noriakinakagawa/JetsonXaiverNX-UPS/README.md

# JetsonXaiverNX-UPS
Jetson Xaiver NXのための、市販のRC用Li-Poバッテリを電源とするUPS装置。
