noriakinakagawa/JetsonXaiverNX-UPS/3Dmodel/CP_Elec_10x10.step

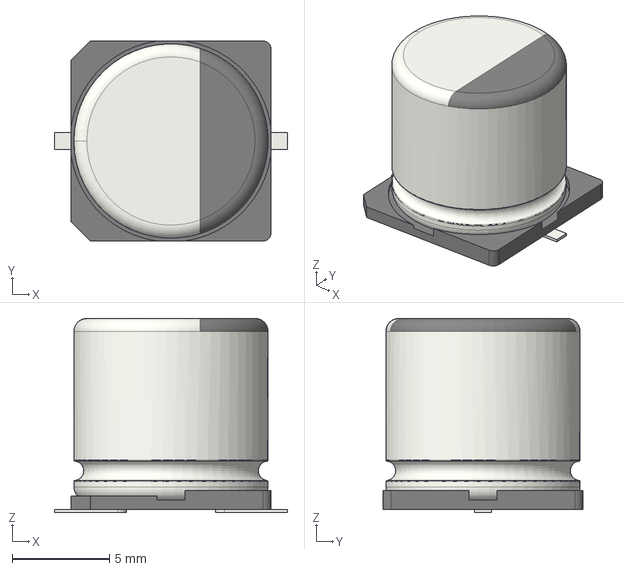
[picture p1: CAD file, 2021-01-03]
3Dmodel/CP_Elec_10x10.step
12.0 x 10.3 x 10.0 mm
