noriakinakagawa/JetsonXaiverNX-UPS/PJ-002B/PJ-002B.step

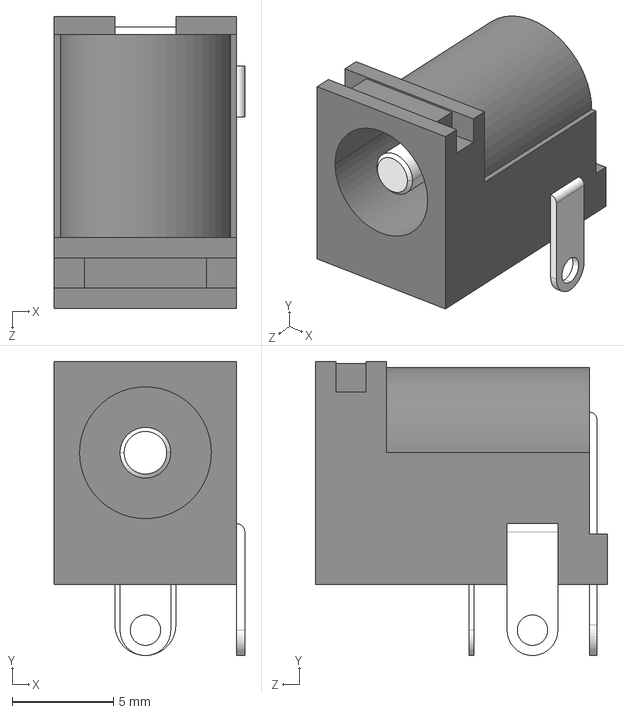
[picture p2: CAD file, 2021-01-03]
PJ-002B/PJ-002B.step
9.40 x 14.5 x 14.4 mm
