noriakinakagawa/JetsonXaiverNX-UPS/3Dmodel/JST_XH_B2B-XH-A_1x02_P2.50mm_Vertical.step

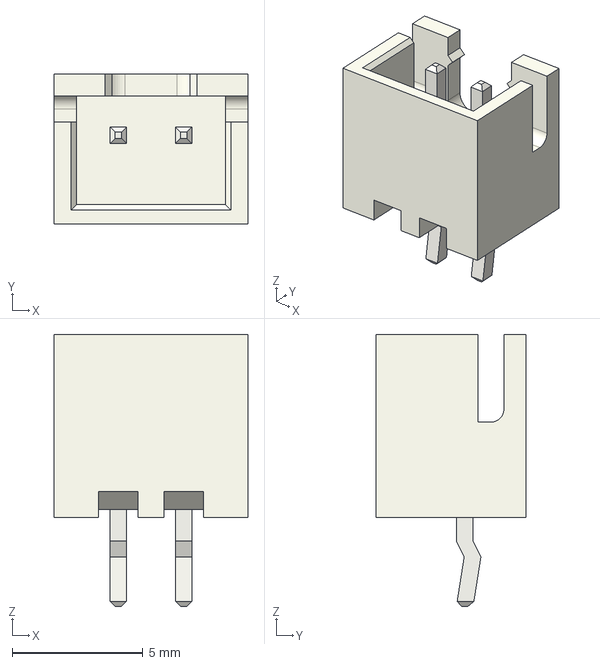
[picture p3: CAD file, 2021-01-03]
3Dmodel/JST_XH_B2B-XH-A_1x02_P2.50mm_Vertical.step
7.40 x 5.75 x 10.4 mm
