noriakinakagawa/JetsonXaiverNX-UPS/3Dmodel/JST_PH_B6B-PH-K_1x06_P2.00mm_Vertical.step

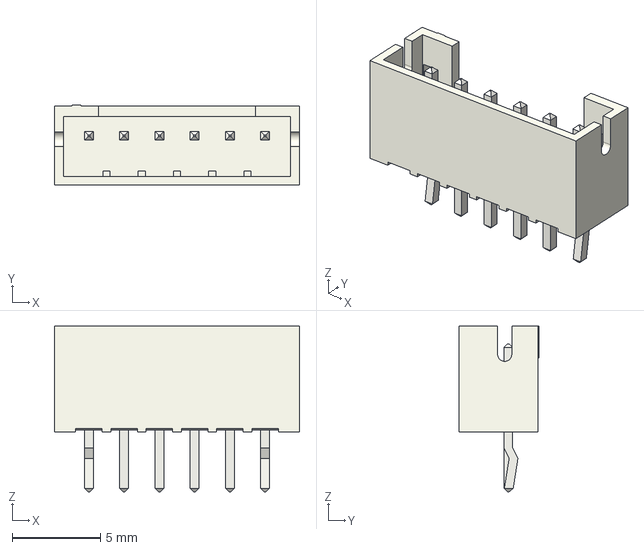
[picture p4: CAD file, 2021-01-03]
3Dmodel/JST_PH_B6B-PH-K_1x06_P2.00mm_Vertical.step
13.9 x 4.55 x 9.40 mm
