noriakinakagawa/JetsonXaiverNX-UPS/3Dmodel/LiPo3S1000mAh_Turnigy.stp

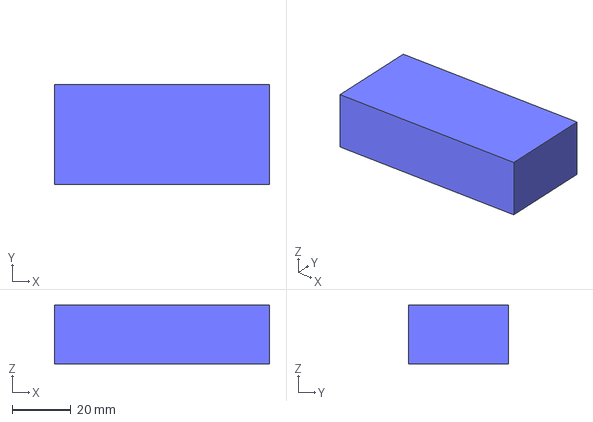
[picture p5: CAD file, 2021-01-03]
3Dmodel/LiPo3S1000mAh_Turnigy.stp
73.0 x 34.0 x 20.0 mm
