noriakinakagawa/JetsonXaiverNX-UPS/3Dmodel/LiPoCharger3S.step

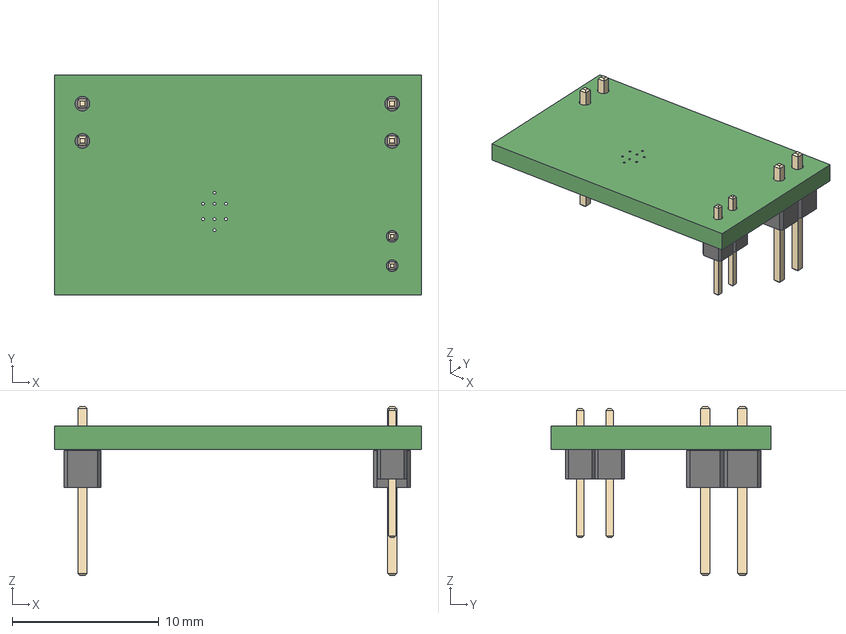
[picture p6: CAD file, 2021-01-03]
3Dmodel/LiPoCharger3S.step
25.0 x 15.0 x 11.5 mm
