noriakinakagawa/JetsonXaiverNX-UPS/3Dmodel/CP_Elec_6.3x5.9.step

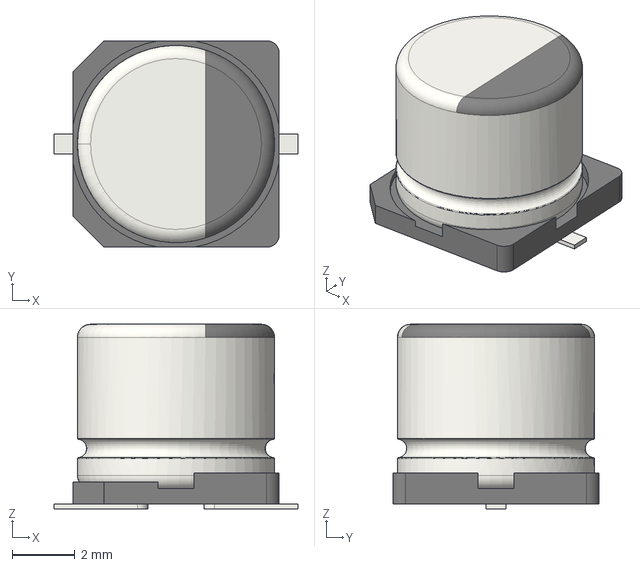
[picture p7: CAD file, 2021-01-03]
3Dmodel/CP_Elec_6.3x5.9.step
7.80 x 6.60 x 5.90 mm
