noriakinakagawa/JetsonXaiverNX-UPS/3Dmodel/JST_XH_B4B-XH-A_1x04_P2.50mm_Vertical.step

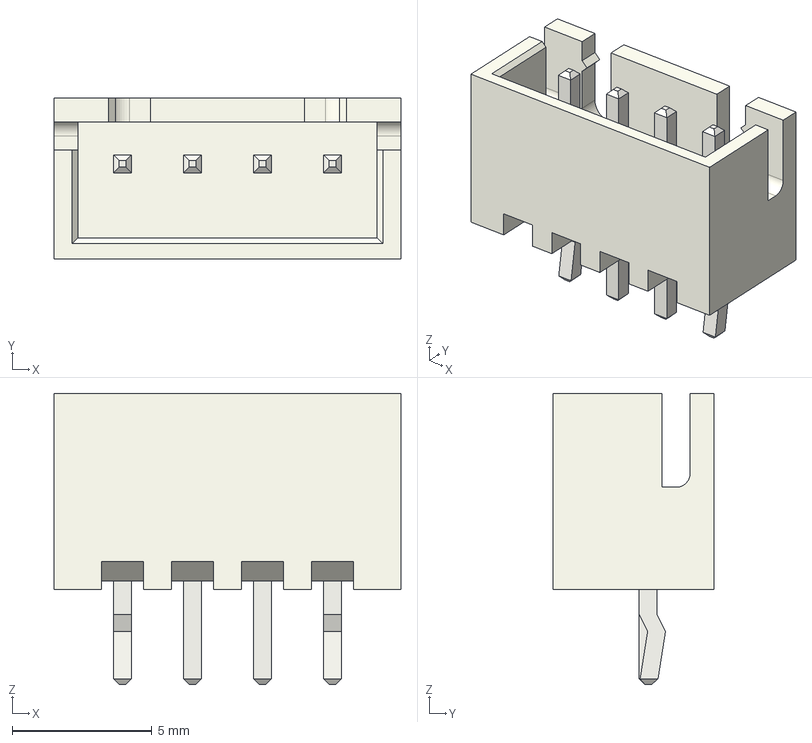
[picture p8: CAD file, 2021-01-03]
3Dmodel/JST_XH_B4B-XH-A_1x04_P2.50mm_Vertical.step
12.4 x 5.75 x 10.4 mm
