noriakinakagawa/JetsonXaiverNX-UPS/3Dmodel/MGFS80.stp

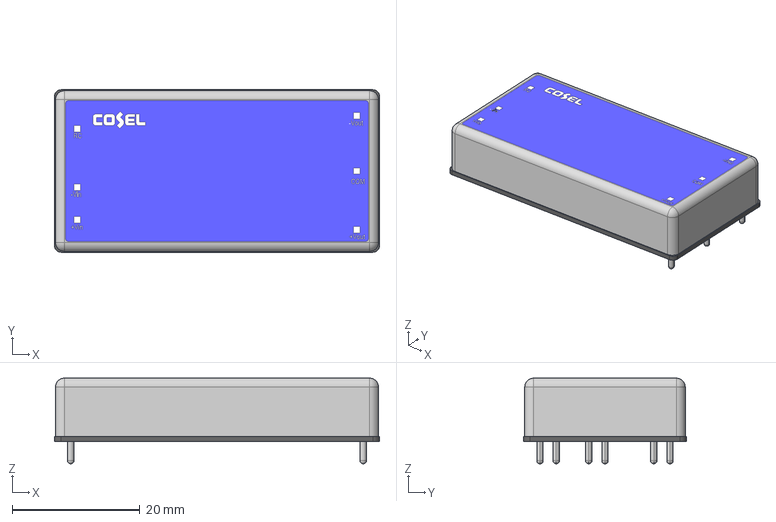
[picture p9: CAD file, 2021-01-03]
3Dmodel/MGFS80.stp
50.8 x 25.4 x 13.4 mm
