noriakinakagawa/JetsonXaiverNX-UPS/3Dmodel/JST_PH_B4B-PH-K_1x04_P2.00mm_Vertical.step

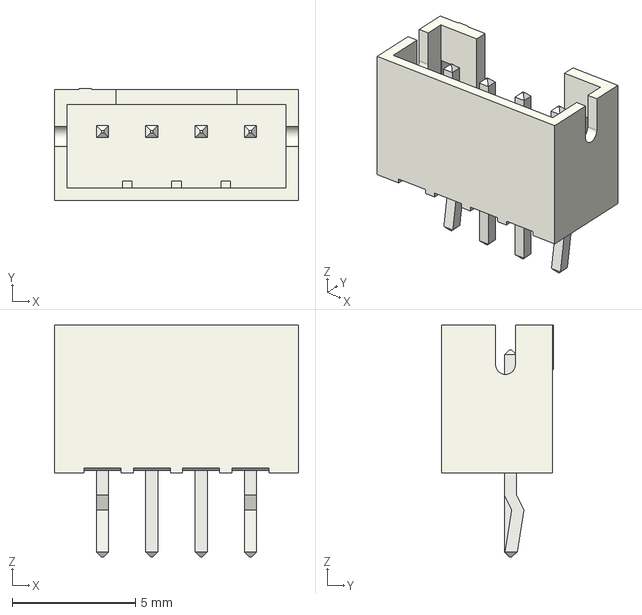
[picture p10: CAD file, 2021-01-03]
3Dmodel/JST_PH_B4B-PH-K_1x04_P2.00mm_Vertical.step
9.90 x 4.55 x 9.40 mm
