noriakinakagawa/JetsonXaiverNX-UPS/JetsonXavierNX_UPS.pdf

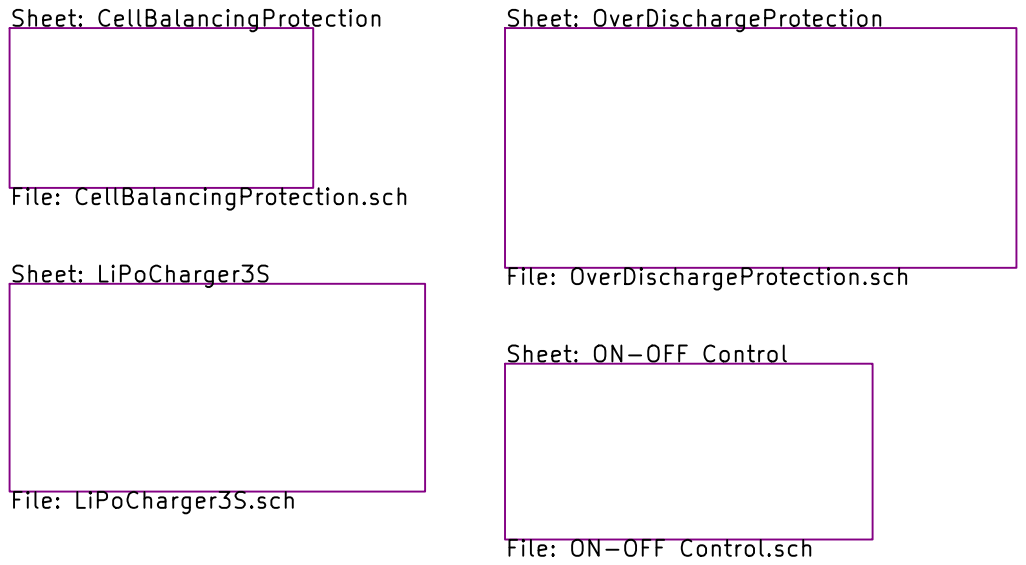
[picture p11: page 1]

File: JetsonXavierNX_UPS.sch Sheet: / Noriaki Nakagawa

Id: 1/5 Title: Jetson Xavier NX UPS

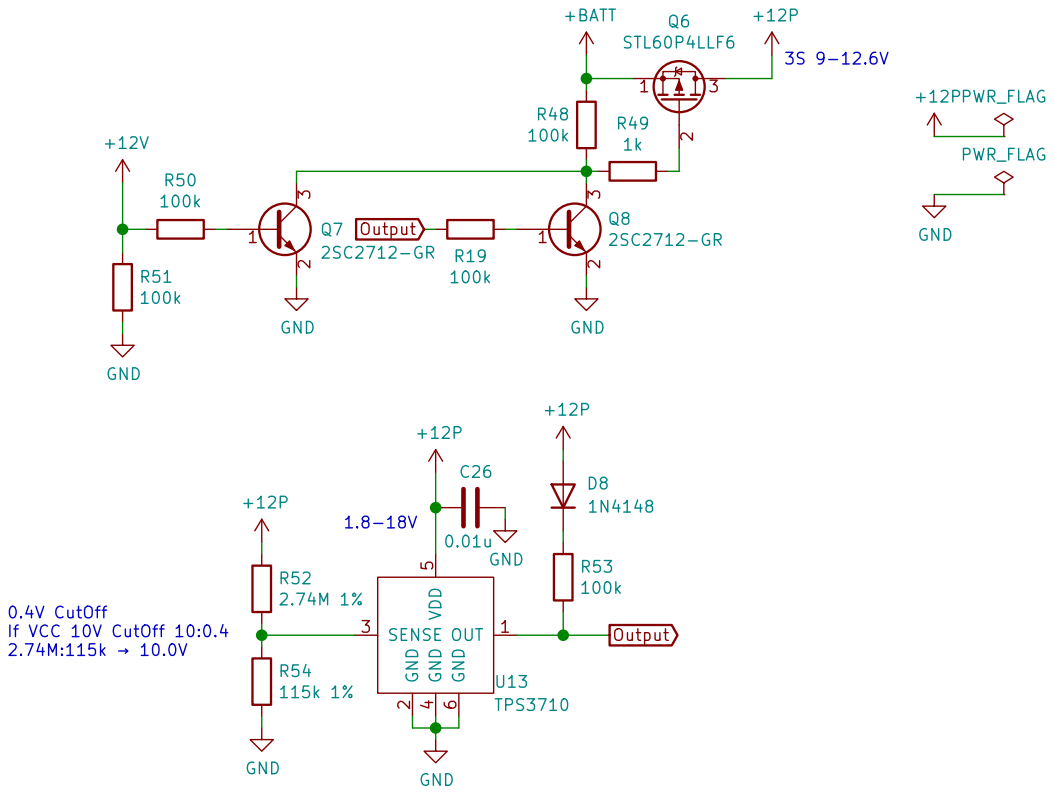
[picture p12: page 2]

Sheet: /OverDischargeProtection/
File: OverDischargeProtection.sch
Id: 2/5 Title: Over Discharge Protection

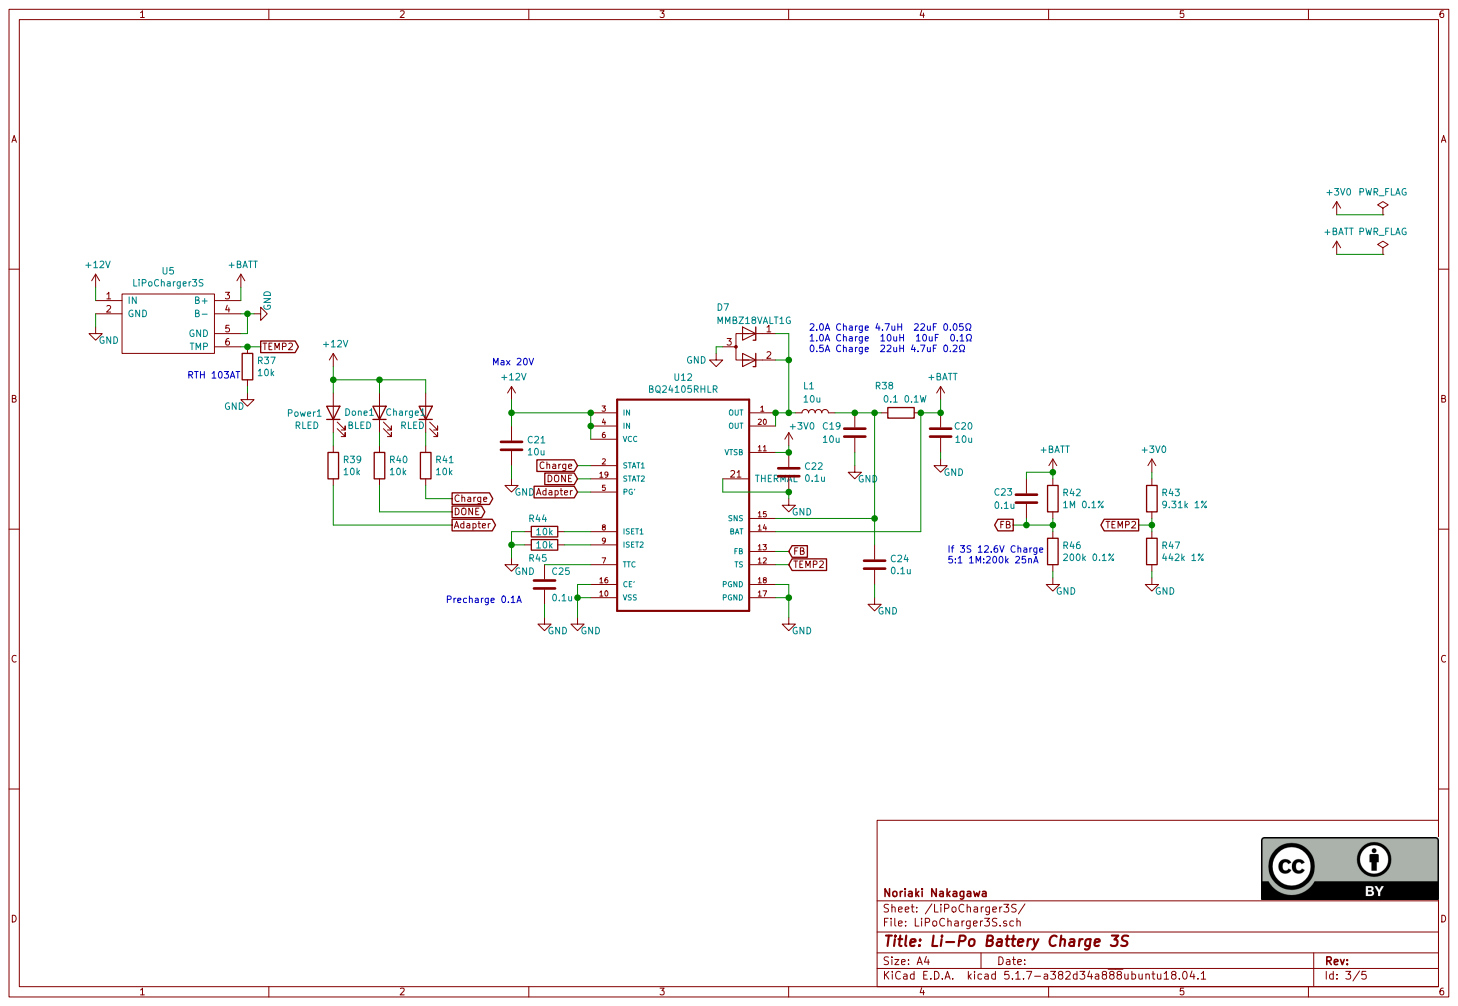
[picture p13: page 3]

Sheet: /LiPoCharger3S/
File: LiPoCharger3S.sch
Id: 3/5 Title: Li-Po Battery Charge 3S

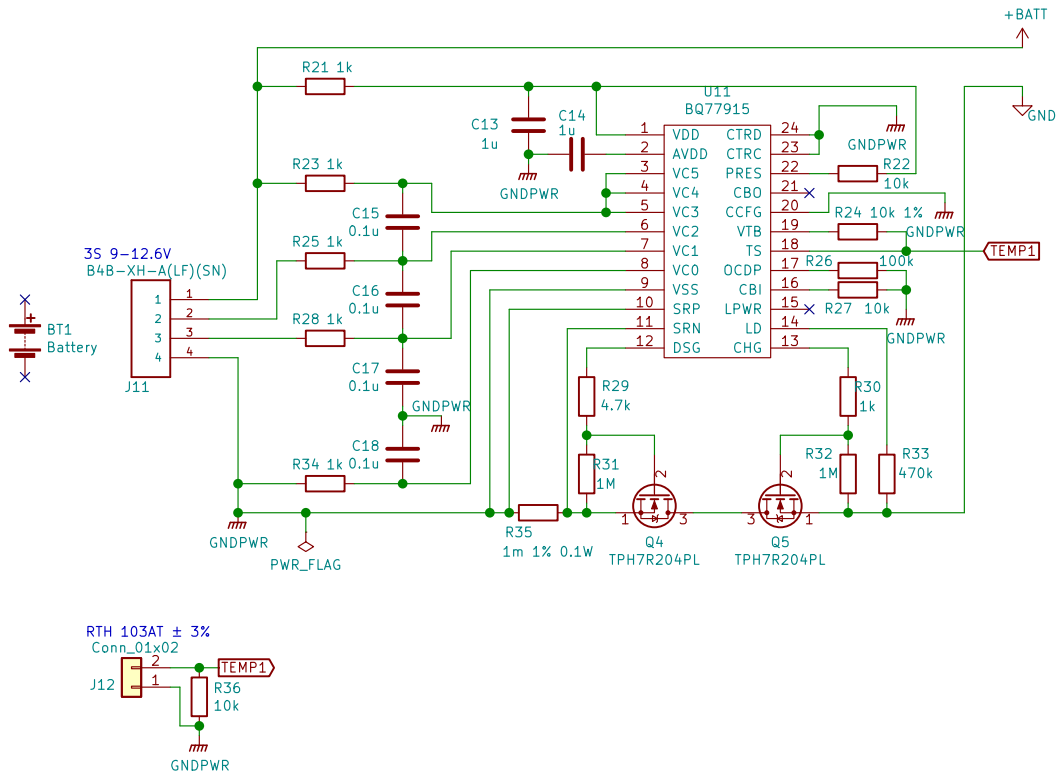
[picture p14: page 4]

Sheet: /CellBalancingProtection/
File: CellBalancingProtection.sch
Id: 4/5 Title: Cell Balance Protection

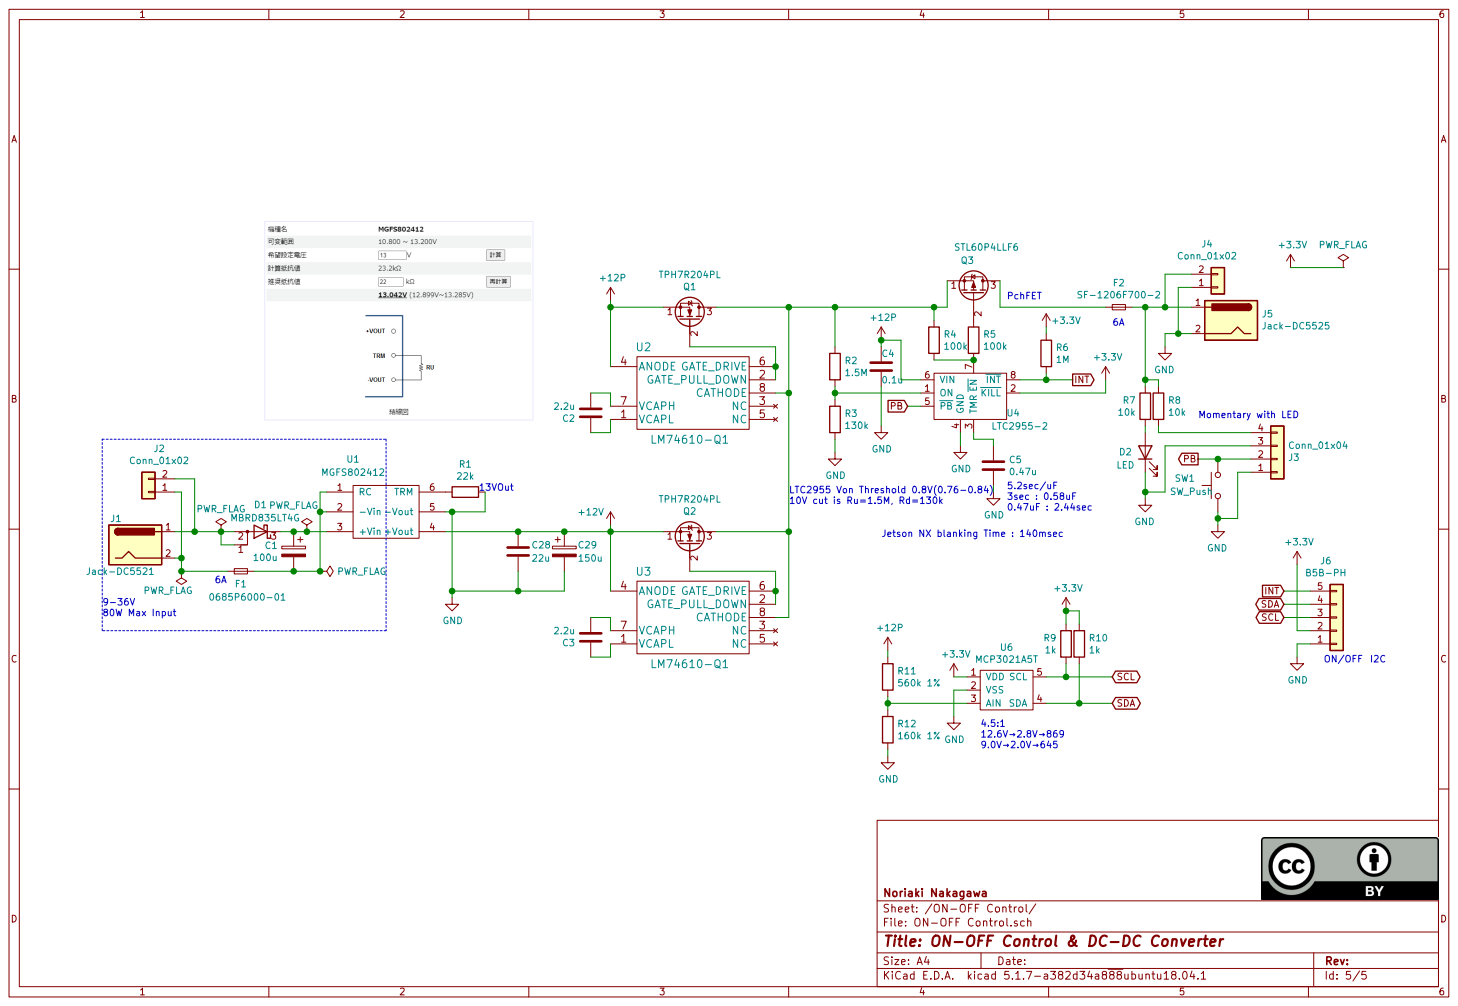
[picture p15: page 5]

Jetson NX blanking Time : 140msec 9-36V

Id: 5/5 Title: ON-OFF Control & DC-DC Converter File: ON-OFF Control.sch Sheet: /ON-OFF Control/ Noriaki Nakagawa
