noriakinakagawa/JetsonXaiverNX-UPS/JetsonXavierNX_UPS.kicad_pcb

## KiCad design JetsonXavierNX_UPS.kicad_pcb (2021-01-03)

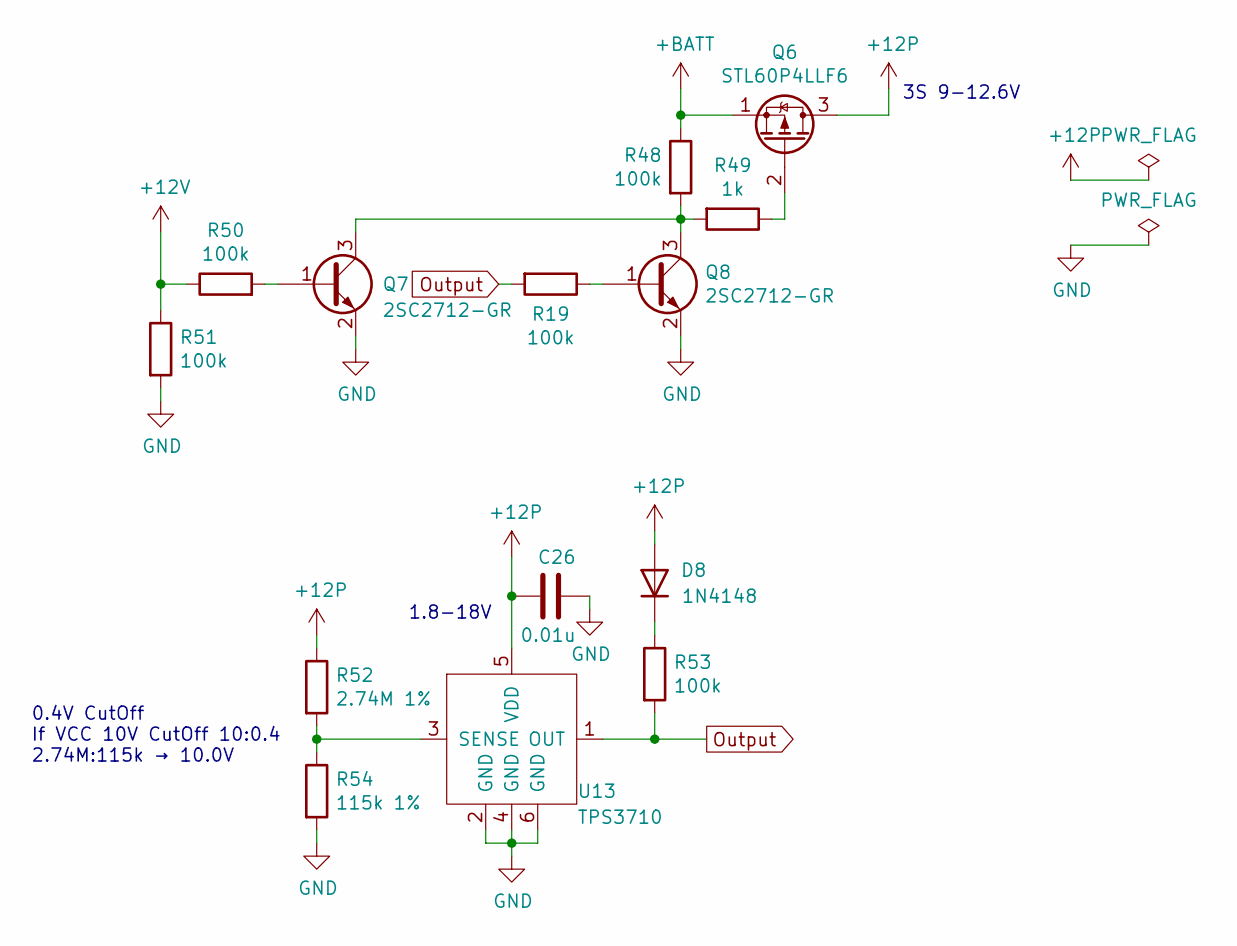
[picture p16: schematic OverDischargeProtection.sch, Over Discharge Protection]

Parts:
C26: 0.01u; C_0603
D8: 1N4148; D_SOD-123
Q6: STL60P4LLF6; 8-PowerVDFN
Q7, Q8: 2SC2712-GR; SC-59
R19, R48, R50, R51, R53: 100k; R_0603
R49: 1k; R_0603
R52: 2.74M 1%; R_0603
R54: 115k 1%; R_0603
U13: TPS3710; TSOT-23-6

Connections:
+12P: C26.1, D8.2 (A), Q6.3 (D), R52.1, U13.5 (VDD); also elsewhere on the board
+12V: R50.1, R51.1; also elsewhere on the board
+BATT: Q6.1 (S), R48.1; also elsewhere on the board
GND: C26.2, Q7.2 (E), Q8.2 (E), R51.2, R54.2, U13.2 (GND), U13.4 (GND), U13.6 (GND); also elsewhere on the board
unnamed: D8.1 (K), R53.1
unnamed: Q6.2 (G), R49.1
unnamed: Q7.1 (B), R50.2
unnamed: Q7.3 (C), Q8.3 (C), R48.2, R49.2
unnamed: Q8.1 (B), R19.1
unnamed: R52.2, R54.1, U13.3 (SENSE)
Output: R19.2, R53.2, U13.1 (OUT)

Notes on the sheet:
1.8-18V
3S 9-12.6V
0.4V CutOff If VCC 10V CutOff 10:0.4 2.74M:115k → 10.0V

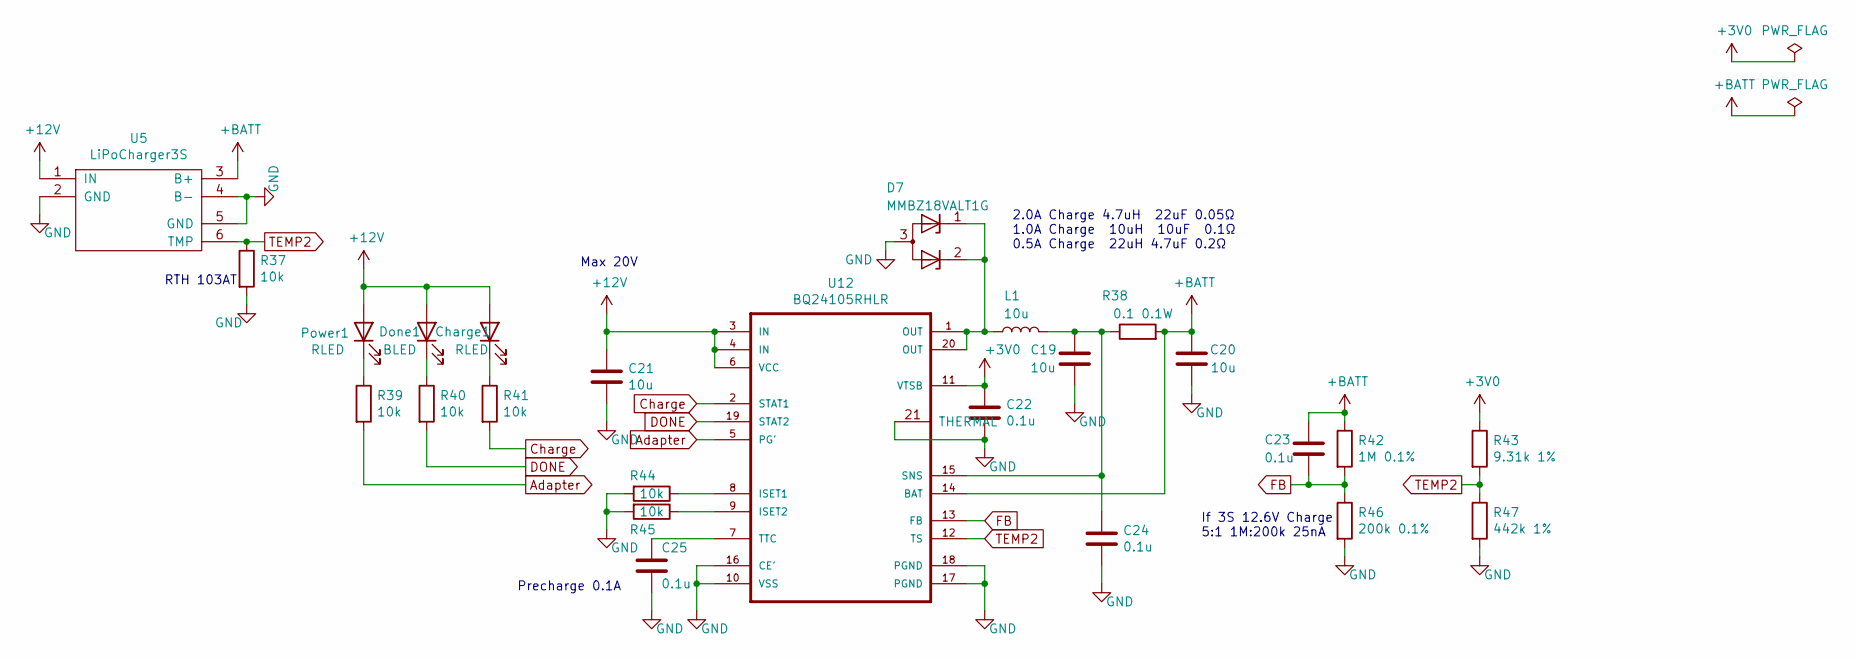
[picture p17: schematic LiPoCharger3S.sch, Li-Po Battery Charge 3S]

Parts:
C19, C20, C21: 10u; C_0805
C22, C23, C24, C25: 0.1u; C_0603
Charge1: RLED; LED_0603
D7: MMBZ18VALT1G; SOT-23
Done1: BLED; LED_0603
L1: 10u; Inductor_Taiyo-Yuden_NR-50xx
Power1: RLED; LED_0603
R37, R39, R40, R41, R44, R45: 10k; R_0603
R38: 0.1 0.1W; R_1206
R42: 1M 0.1%; R_0603
R43: 9.31k 1%; R_0603
R46: 200k 0.1%; R_0603
R47: 442k 1%; R_0603
U5: LiPoCharger3S
U12: BQ24105RHLR; IC_MSP430FR2522IRHLR

Connections:
+3V0: C22.1, R43.1, U12.11 (VTSB)
+12V: C21.1, Charge1.2 (A), Done1.2 (A), Power1.2 (A), U5.1 (IN), U12.3 (IN), U12.4 (IN), U12.6 (VCC); also elsewhere on the board
+BATT: C20.1, C23.1, R38.2, R42.1, U5.3 (B+), U12.14 (BAT); also elsewhere on the board
Adapter: R39.2, U12.5 (PG')
Charge: R41.2, U12.2 (STAT1)
DONE: R40.2, U12.19 (STAT2)
FB: C23.2, R42.2, R46.1, U12.13 (FB)
GND: C19.2, C20.2, C21.2, C22.2, C24.2, C25.2, D7.3 (A), R37.2, R44.2, R45.2, R46.2, R47.2, U5.2 (GND), U5.4 (B-), U5.5 (GND), U12.10 (VSS), U12.16 (CE'), U12.17 (PGND), U12.18 (PGND), U12.21 (THERMAL); also elsewhere on the board
unnamed: C19.1, C24.1, L1.2, R38.1, U12.15 (SNS)
unnamed: C25.1, U12.7 (TTC)
unnamed: Charge1.1 (K), R41.1
unnamed: D7.1 (K), D7.2 (K), L1.1, U12.1 (OUT), U12.20 (OUT)
unnamed: Done1.1 (K), R40.1
unnamed: Power1.1 (K), R39.1
unnamed: R44.1, U12.8 (ISET1)
unnamed: R45.1, U12.9 (ISET2)
TEMP2: R37.1, R43.2, R47.1, U5.6 (TMP), U12.12 (TS)

Notes on the sheet:
If 3S 12.6V Charge 5:1 1M:200k 25nA
Precharge 0.1A
2.0A Charge 4.7uH 22uF 0.05Ω 1.0A Charge 10uH 10uF 0.1Ω 0.5A Charge 22uH 4.7uF 0.2Ω
Max 20V
RTH 103AT

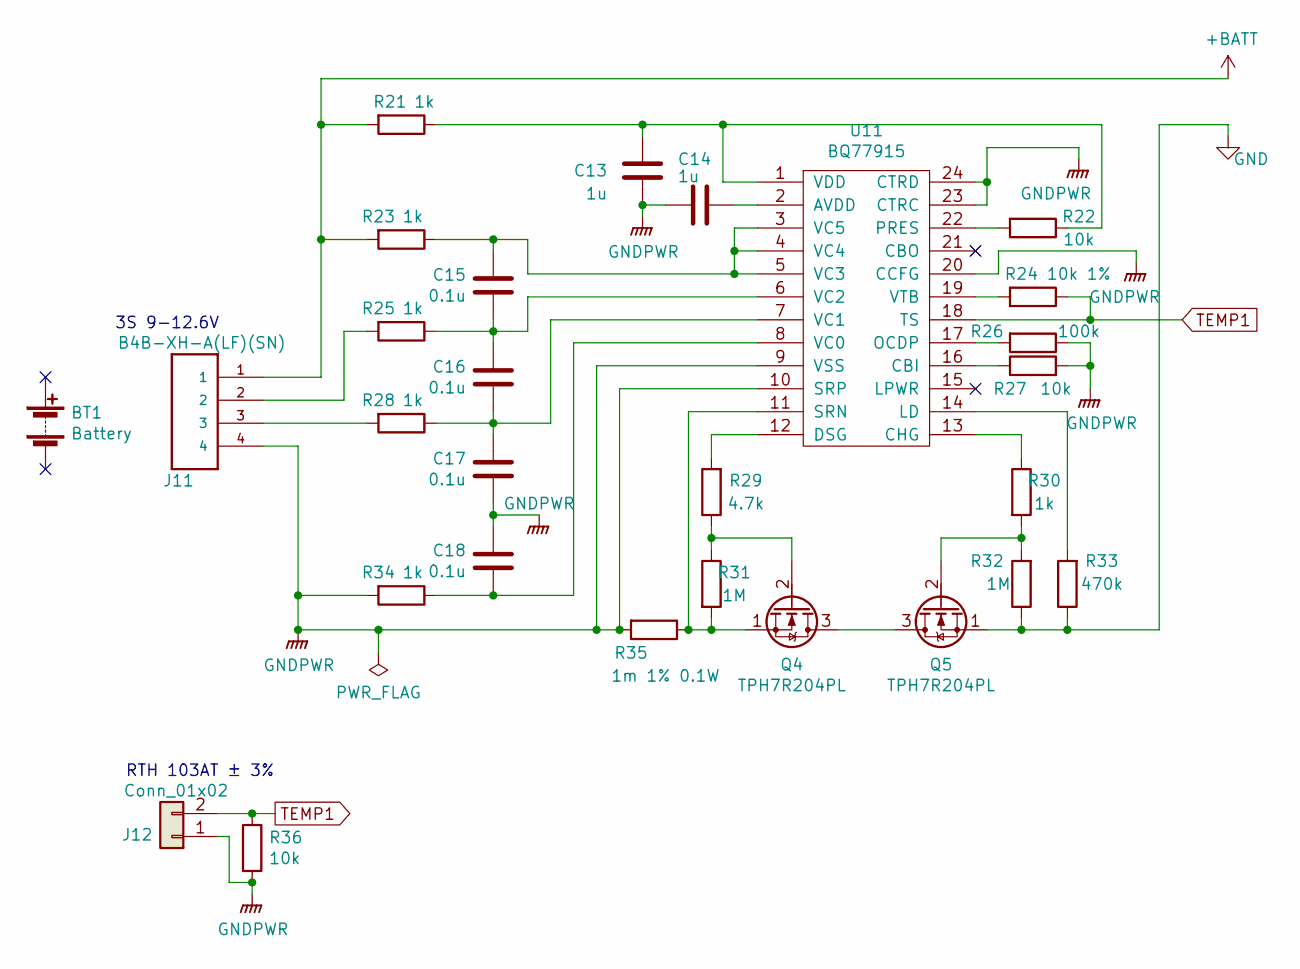
[picture p18: schematic CellBalancingProtection.sch, Cell Balance Protection]

Parts:
BT1: Battery; LiPo3S1000mAh
C13, C14: 1u; C_0603
C15, C16, C17, C18: 0.1u; C_0603
J11: B4B-XH-A(LF)(SN); JST_XH_B04B-XH-A_04x2.50mm_Straight
J12: Conn_01x02; Pin_Header_Straight_1x02_Pitch2.00mm
Q4, Q5: TPH7R204PL; 8-PowerVDFN
R21, R23, R25, R28, R30, R34: 1k; R_0603
R22, R27, R36: 10k; R_0603
R24: 10k 1%; R_0603
R26: 100k; R_0603
R29: 4.7k; R_0603
R31, R32: 1M; R_0603
R33: 470k; R_0603
R35: 1m 1% 0.1W; R_1206
U11: BQ77915; TSSOP-24_4.4x7.8mm_Pitch0.65mm

Connections:
+BATT: J11.1, R21.2, R23.2; also elsewhere on the board
GND: Q5.1 (S), R32.1, R33.1; also elsewhere on the board
GNDPWR: C13.1, C14.2, C17.2, C18.1, J11.4, J12.1, R26.1, R27.2, R34.2, R35.2, R36.2, U11.9 (VSS), U11.10 (SRP), U11.20 (CCFG), U11.23 (CTRC), U11.24 (CTRD); also elsewhere on the board
unnamed: C13.2, R21.1, R22.1, U11.1 (VDD)
unnamed: C14.1, U11.2 (AVDD)
unnamed: C15.1, R23.1, U11.3 (VC5), U11.4 (VC4), U11.5 (VC3)
unnamed: C15.2, C16.1, R25.1, U11.6 (VC2)
unnamed: C16.2, C17.1, R28.1, U11.7 (VC1)
unnamed: C18.2, R34.1, U11.8 (VC0)
unnamed 37: J11.2, R25.2; also elsewhere on the board
unnamed 38: J11.3, R28.2; also elsewhere on the board
unnamed: Q4.1 (S), R31.2, R35.1, U11.11 (SRN)
unnamed: Q4.2 (G), R29.1, R31.1
unnamed: Q4.3 (D), Q5.3 (D)
unnamed: Q5.2 (G), R30.2, R32.2
unnamed: R22.2, U11.22 (PRES)
unnamed: R24.2, U11.19 (VTB)
unnamed: R26.2, U11.17 (OCDP)
unnamed: R27.1, U11.16 (CBI)
unnamed: R29.2, U11.12 (DSG)
unnamed: R30.1, U11.13 (CHG)
unnamed: R33.2, U11.14 (LD)
TEMP1: J12.2, R24.1, R36.1, U11.18 (TS)

Notes on the sheet:
3S 9-12.6V
RTH 103AT ± 3%

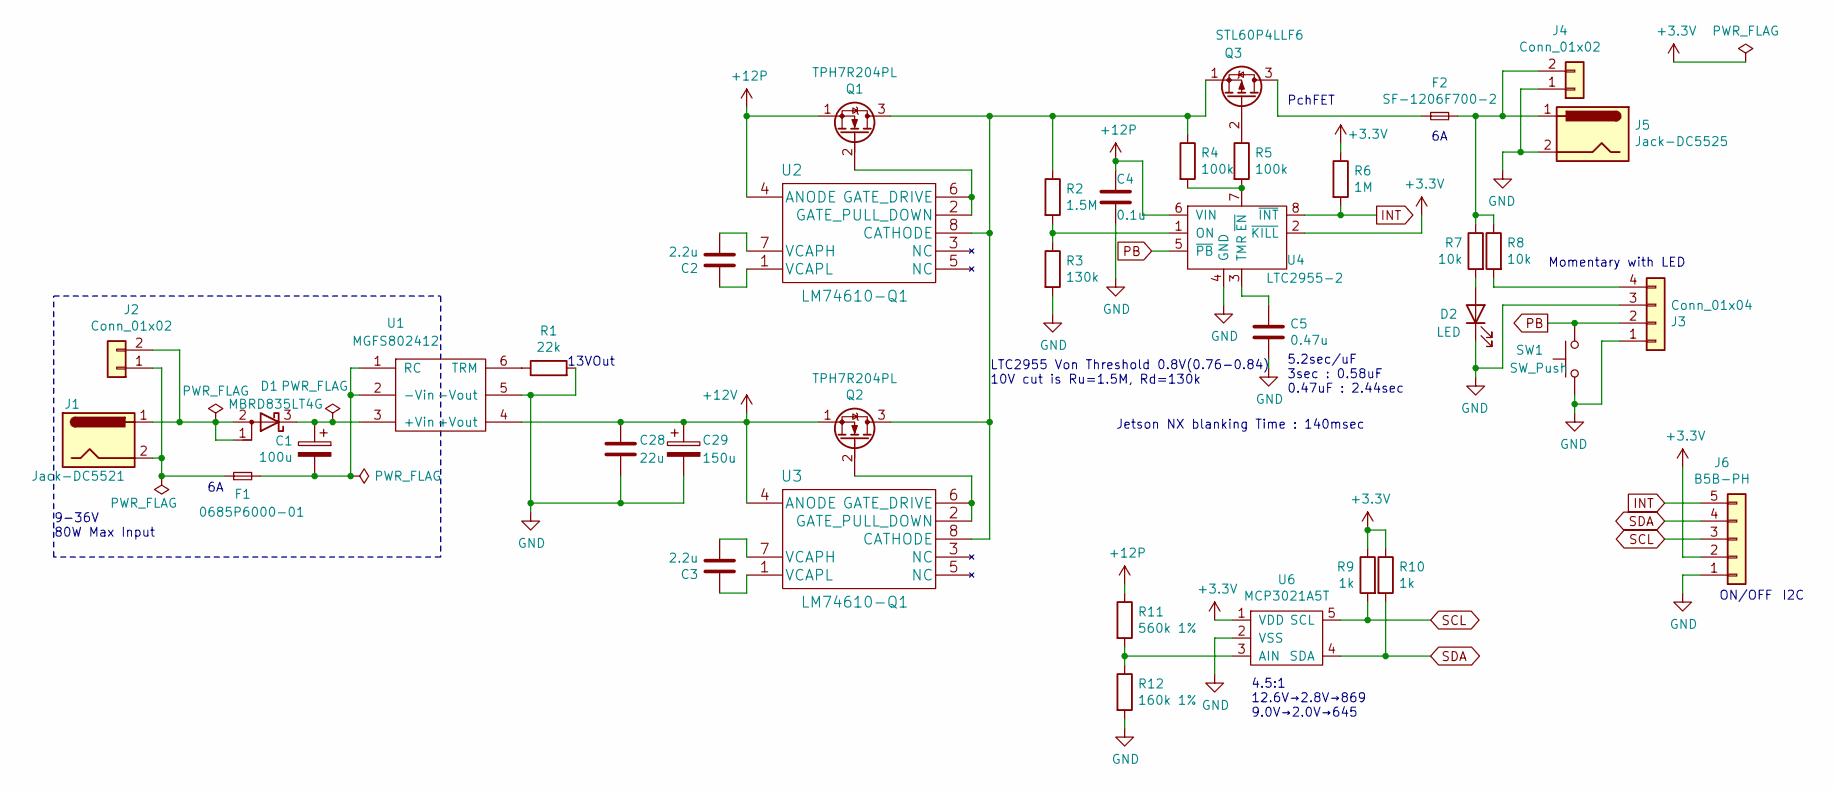
[picture p19: schematic ON-OFF Control.sch, ON-OFF Control & DC-DC Converter]

Parts:
C1: 100u; EEE-1VA101XP
C2, C3: 2.2u; C_0603
C4: 0.1u; C_0603
C5: 0.47u; C_0603
C28: 22u; C_1210
C29: 150u; PCR1V151MCL1GS
D1: MBRD835LT4G; TO-252-3
D2: LED; LED_0603
F1: 0685P6000-01; Fuse_SMD1206_HandSoldering
F2: SF-1206F700-2; Fuse_SMD1206_HandSoldering
J1: Jack-DC5521; CUI_PJ-002B
J2, J4: Conn_01x02; JST_XH_B02B-XH-A_02x2.50mm_Straight
J3: Conn_01x04; JST_PH_B4B-PH-K_04x2.00mm_Straight
J5: Jack-DC5525; CUI_PJ-002B
J6: B5B-PH; JST_PH_B5B-PH-K_05x2.00mm_Straight
Q1, Q2: TPH7R204PL; 8-PowerVDFN
Q3: STL60P4LLF6; 8-PowerVDFN
R1: 22k; R_0603
R2: 1.5M; R_0603
R3: 130k; R_0603
R4, R5: 100k; R_0603
R6: 1M; R_0603
R7, R8: 10k; R_0603
R9, R10: 1k; R_0603
R11: 560k 1%; R_0603
R12: 160k 1%; R_0603
SW1: SW_Push; SW_Tactile_SPST_Angled_PTS645Vx83-2LFS
U1: MGFS802412; MGFS80
U2, U3: LM74610-Q1; 8-VSSOP
U4: LTC2955-2; TSOT-23-8
U6: MCP3021A5T; SOT-23-5

Connections:
+3V3: J6.2, R6.1, R9.1, R10.1, U4.2 (~KILL), U6.1 (VDD)
+12P: C4.1, Q1.1 (S), R11.1, U2.4 (ANODE), U4.6 (VIN); also elsewhere on the board
+12V: C28.1, C29.1, Q2.1 (S), U1.4 (+Vout), U3.4 (ANODE); also elsewhere on the board
GND: C4.2, C5.2, C28.2, C29.2, D2.1 (K), J3.1, J3.3, J4.1, J5.2, J6.1, R1.2, R3.2, R12.2, SW1.1, U1.5 (-Vout), U4.4 (GND), U6.2 (VSS); also elsewhere on the board
INT: J6.5, R6.2, U4.8 (~INT)
unnamed: C1.1, D1.3 (K), U1.3 (+Vin)
unnamed: C1.2, F1.2, U1.1 (RC), U1.2 (-Vin)
unnamed: C2.1, U2.1 (VCAPL)
unnamed: C2.2, U2.7 (VCAPH)
unnamed: C3.1, U3.1 (VCAPL)
unnamed: C3.2, U3.7 (VCAPH)
unnamed: C5.1, U4.3 (TMR)
unnamed: D1.1 (A), D1.2 (A), J1.1, J2.2
unnamed: D2.2 (A), R7.2
unnamed: F1.1, J1.2, J2.1
unnamed: F2.1, Q3.3 (D)
unnamed: F2.2, J4.2, J5.1, R7.1, R8.1
unnamed: J3.4, R8.2
unnamed: Q1.2 (G), U2.2 (GATE_PULL_DOWN), U2.6 (GATE_DRIVE)
unnamed: Q1.3 (D), Q2.3 (D), Q3.1 (S), R2.1, R4.1, U2.8 (CATHODE), U3.8 (CATHODE)
unnamed: Q2.2 (G), U3.2 (GATE_PULL_DOWN), U3.6 (GATE_DRIVE)
unnamed: Q3.2 (G), R5.1
unnamed: R1.1, U1.6 (TRM)
unnamed: R2.2, R3.1, U4.1 (ON)
unnamed: R4.2, R5.2, U4.7 (~EN)
unnamed: R11.2, R12.1, U6.3 (AIN)
PB: J3.2, SW1.2, U4.5 (~PB)
SCL: J6.3, R9.2, U6.5 (SCL)
SDA: J6.4, R10.2, U6.4 (SDA)

Notes on the sheet:
PchFET
ON/OFF
I2C
4.5:1 12.6V→2.8V→869 9.0V→2.0V→645
13VOut
Jetson NX blanking Time : 140msec
9-36V 80W Max Input
Momentary with LED
5.2sec/uF 3sec : 0.58uF 0.47uF : 2.44sec
LTC2955 Von Threshold 0.8V(0.76-0.84) 10V cut is Ru=1.5M, Rd=130k

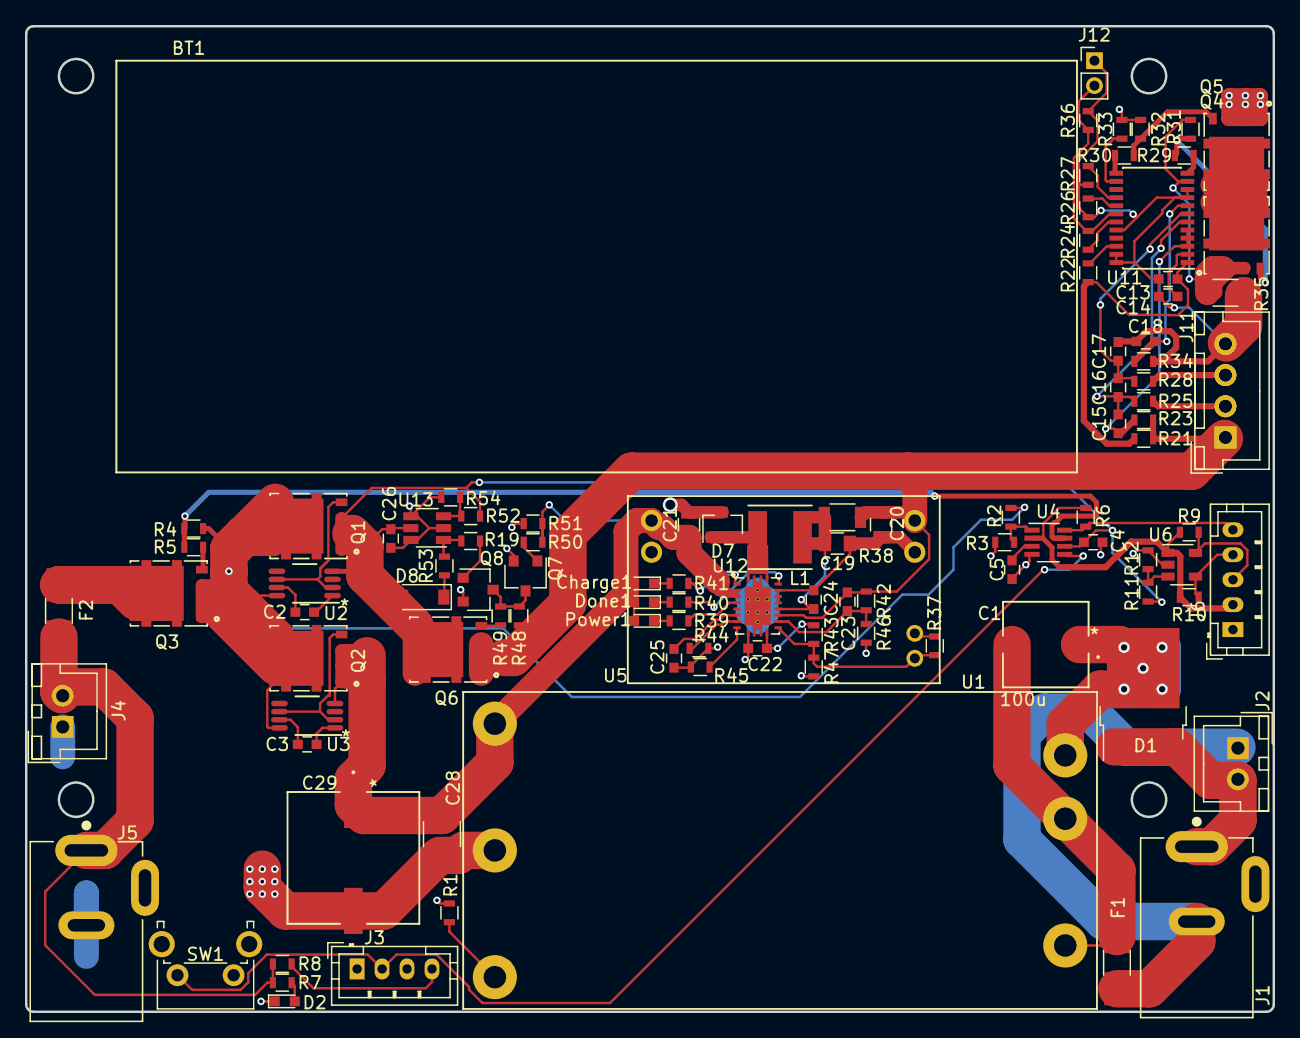
[picture p20: board JetsonXavierNX_UPS.kicad_pcb from above]

Board: 2 copper layers, 100.0 x 79.0 mm, 106 parts (1 on the bottom side), 72 nets.

Other parts of the board:
J11#2: B4B-XH-A(LF)(SN); JST_XH_B04B-XH-A_04x2.50mm_Straight

Their connections:
+BATT: J11#2.1; also elsewhere on the board
GNDPWR: J11#2.4; also elsewhere on the board
unnamed 37: J11#2.2; also elsewhere on the board
unnamed 38: J11#2.3; also elsewhere on the board
