noriakinakagawa/JetsonXaiverNX-UPS/(notices)

Notices in the files:
3Dmodel/CP_Elec_10x10.step:
Copyright (C) 2018, kicad StepUp
This work is licensed under the [Creative Commons CC-BY-SA 4.0 License](https://creativecommons.org/licenses/by-sa/4.0/legalcode),
with the following exception:
To the extent that the creation of electronic designs that use 'Licensed Material' can be considered to be 'Adapted Material',
You are free to use the library data in your own projects without the obligation to share your project files under this or any other license agreement.
3Dmodel/JST_XH_B2B-XH-A_1x02_P2.50mm_Vertical.step:
Copyright (C) 2019, Rene Poeschl
3Dmodel/JST_PH_B4B-PH-K_1x04_P2.00mm_Vertical.step:
Copyright (C) 2017, Rene Poeschl
